malvira/econotag/README.md

CAD and Docs for the Econotag
================================

License
-------

The TH12 designs are owned by Redwire Consulting, LLC and relased
under the [CERN OPEN HARDWARE LICENCE v1.1](LICENSE.txt)
