malvira/econotag/r2/econotag-r2-bom.ods

 | qty | run price | unit price | Sale price | Profit
Pilot | 1 | 48 | 48 | 55 | 31.79
Limited | 100 | 3060 | 31 | 55 | 2439.75
Production | 1000 | 21424 | 21 | 45 | 23575.6
Quantity | Manufacturer | Part Number | Value | Description | Digikey | Mouser | 1 | 100 | 1000 | Pilot Total | LP total | Prod Tot | Pilot $ | Pilot % | LP $ | LP % | P $ | P %
3 | Murata | GRM188F51E105ZA12D | 1uF | Multilayer Ceramic Capacitors (MLCC) - SMD/SMT 0603 1uF 25volts Y5V +80-20% |  | 81-GRM188F51E105ZA12 | 0.0700 | 0.0420 | 0.0160 | 3 | 300 | 3000 | $0.21 | 0.4% | $12.60 | 0.4% | $48.00 | 0.2%
2 | Murata | GRM21BR60J106KE19L | 10uF | Multilayer Ceramic Capacitors (MLCC) - SMD/SMT 0805 10uF 6.3volts X5R 10% |  | 81-GRM21R60J106KE19L | 0.3200 | 0.1910 | 0.0600 | 2 | 200 | 2000 | $0.64 | 1.3% | $38.20 | 1.2% | $120.00 | 0.6%
2 | Kemet | C0603C120C5GACTU | 12pF | Multilayer Ceramic Capacitors (MLCC) - SMD/SMT 50volts 12pF C0G 0.25% |  | 80-C0603C120C5G | 0.7600 | 0.4520 | 0.1250 | 2 | 200 | 2000 | $1.52 | 3.2% | $90.40 | 3.0% | $250.00 | 1.2%
3 | Taiyo Yuden | TMK107BJ104KA-T | 0.1uF | CAP CER .10UF 25V X5R 0603 | 587-1245-1-ND |  | 0.0330 | 0.0195 | 0.0078 | 3 | 300 | 3000 | $0.10 | 0.2% | $5.85 | 0.2% | $23.40 | 0.1%
1 | Vishay/Vitramon | VJ0603A471JXAAC | 470pF | Multilayer Ceramic Capacitors (MLCC) - SMD/SMT 470pF 50volts 5% |  | 77-VJ0603A471JXAAC | 0.0400 | 0.0200 | 0.0200 | 1 | 100 | 1000 | $0.04 | 0.1% | $2.00 | 0.1% | $20.00 | 0.1%
2 | Murata | GRM1885C1H180GA01D | 18pF | Multilayer Ceramic Capacitors (MLCC) - SMD/SMT 0603 18pF 50volts C0G 2% |  | 81-GRM1885C1H180GA | 0.0700 | 0.0440 | 0.0170 | 2 | 200 | 2000 | $0.14 | 0.3% | $8.80 | 0.3% | $34.00 | 0.2%
1 | NXP Semiconductors | PMEG3010ER,115 |  | Schottky (Diodes & Rectifiers) SCHOTTKY DIODE |  | 771-PMEG3010ER115 | 0.1200 | 0.1100 | 0.0960 | 1 | 100 | 1000 | $0.12 | 0.2% | $11.00 | 0.4% | $96.00 | 0.4%
1 | Molex | 48037-1000 | MOLEX-48037-NOHOLES | USB & Firewire Connectors TYPE A RA SHLDED PLG SMT AU |  | 538-48037-1000 | 2.0500 | 1.2000 | 0.8600 | 1 | 100 | 1000 | $2.05 | 4.3% | $120.00 | 3.9% | $860.00 | 4.0%
1 | Vishay/Dale | CRCW06030000ZSTB | short | Jumper Resistors / Wire Bridges 1/10watt 0ohms JUMPER |  | 71-CRCW0603000ZT-RT5 | 0.0500 | 0.0200 | 0.0100 | 1 | 100 | 1000 | $0.05 | 0.1% | $2.00 | 0.1% | $10.00 | 0.0%
1 | ABRACON | ABLS2-12.000MHZ-D4Y-T | 12MHz | 12MHz xtal 18pF |  | 815-ABLS2-12-D4Y-T | 0.6300 | 0.3800 | 0.2380 | 1 | 100 | 1000 | $0.63 | 1.3% | $38.00 | 1.2% | $238.00 | 1.1%
1 | Abracon Corporation | ABLS-24.000MHZ-D-R60-1-W-T | 24MHz 10ppm | 24MHz xtal 10ppm | 535-9701-1-ND |  | 0.9400 | 0.5625 | 0.4750 | 1 | 100 | 1000 | $0.94 | 1.9% | $56.25 | 1.8% | $475.00 | 2.2%
1 | Kingbright | APT1608SRCPRV | RED | Standard LED - SMD RED WATER CLEAR |  | 604-APT1608SRCPRV | 0.1300 | 0.0710 | 0.0490 | 1 | 100 | 1000 | $0.13 | 0.3% | $7.10 | 0.2% | $49.00 | 0.2%
1 | Lite-On Inc | LTST-C190KGKT | GREEN | LED GREEN CLEAR 0603 SMD | 160-1435-1-ND |  | 0.1200 | 0.0725 | 0.0580 | 1 | 100 | 1000 | $0.12 | 0.2% | $7.25 | 0.2% | $58.00 | 0.3%
1 | Xicon | 302-8.06K-RC | 8.06k | Thick Film Resistors 1/10WATT 8.06KOHMS |  | 302-8.06K-RC | 0.0400 | 0.0250 | 0.0140 | 1 | 100 | 1000 | $0.04 | 0.1% | $2.50 | 0.1% | $14.00 | 0.1%
2 | Bourns | CR0603-JW-102GLF | 1k | Thick Film Resistors 1KOHM 1/10WATT 5% |  | 652-CR0603-JW-102GLF | 0.0300 | 0.0200 | 0.0150 | 2 | 200 | 2000 | $0.06 | 0.1% | $4.00 | 0.1% | $30.00 | 0.1%
1 | Bourns | CR0603-JW-221GLF | 220 | Thick Film Resistors 220OHM 1/10WATT 5% |  | 652-CR0603-JW-221GLF | 0.0300 | 0.0200 | 0.0150 | 1 | 100 | 1000 | $0.03 | 0.1% | $2.00 | 0.1% | $15.00 | 0.1%
1 | Xicon | 301-120-RC | 120 | Thick Film Resistors 1/16WATT 120OHMS |  | 301-120-RC | 0.0400 | 0.0240 | 0.0160 | 1 | 100 | 1000 | $0.04 | 0.1% | $2.40 | 0.1% | $16.00 | 0.1%
1 | Vishay/Dale | CRCW06031K02FKTA | 1.02k | Thick Film Resistors 1/10watt 1.02Kohms 1% |  | 71-CRCW0603-1.02K | 0.0500 | 0.0200 | 0.0100 | 1 | 100 | 1000 | $0.05 | 0.1% | $2.00 | 0.1% | $10.00 | 0.0%
1 | Xicon | 302-15K-RC | 15.0k | Thick Film Resistors 1/10WATT 15KOHMS |  | 302-15K-RC | 0.0400 | 0.0250 | 0.0140 | 1 | 100 | 1000 | $0.04 | 0.1% | $2.50 | 0.1% | $14.00 | 0.1%
2 | KOA Speer | RK73B1JTTD563J | 56k | Thick Film Resistors 1/10watts 56Kohms 5% |  | 660-RK73B1JTTD563J | 0.0600 | 0.0200 | 0.0160 | 2 | 200 | 2000 | $0.12 | 0.2% | $4.00 | 0.1% | $32.00 | 0.1%
1 | KOA Speer | RK73H1JTTD1202F | 12k | Thick Film Resistors 1/10watts 12Kohms 1% |  | 660-RK73H1JTTD1202F | 0.0800 | 0.0200 | 0.0150 | 1 | 100 | 1000 | $0.08 | 0.2% | $2.00 | 0.1% | $15.00 | 0.1%
1 | Xicon | 301-10M-RC | 10M | Thick Film Resistors 1/16WATT 10MOHMS |  | 301-10M-RC | 0.0400 | 0.0240 | 0.0160 | 1 | 100 | 1000 | $0.04 | 0.1% | $2.40 | 0.1% | $16.00 | 0.1%
1 | Bourns | CR0603-JW-333GLF | 33k | Thick Film Resistors 33KOHM 1/10WATT 5% |  | 652-CR0603-JW-333GLF | 0.0300 | 0.0200 | 0.0150 | 1 | 100 | 1000 | $0.03 | 0.1% | $2.00 | 0.1% | $15.00 | 0.1%
3 | C&K Components | KSC243JLFG |  | Tactile & Jog Switches Gold 300Gf J-Lead |  | 611-KSC243JLFG | 0.5400 | 0.4000 | 0.2560 | 3 | 300 | 3000 | $1.62 | 3.4% | $120.00 | 3.9% | $768.00 | 3.6%
1 | Freescale Semiconductor | MC13224V | MC13224V-LGA145 | RF Transceiver PIP 802.15.4 2.4G IND Learn More |  | 841-MC13224V | 5.8500 | 5.1100 | 5.1100 | 1 | 100 | 1000 | $5.85 | 12.1% | $511.00 | 16.7% | $5,110.00 | 23.9%
1 | FTDI, Future Technology Devices International Ltd | FT2232HL - REEL | FT2232HL | IC USB UART/FIFO DUAL HS 64LQFP | 768-1024-1-ND |  | 6.7100 | 5.4000 | 4.0600 | 1 | 100 | 1000 | $6.71 | 13.9% | $540.00 | 17.6% | $4,060.00 | 19.0%
1 | Micrel Inc | MIC5205YM5 TR | MIC5205-BM5 | Adj. Vreg | 576-1262-1-ND |  | 0.8100 | 0.5400 | 0.3780 | 1 | 100 | 1000 | $0.81 | 1.7% | $54.00 | 1.8% | $378.00 | 1.8%
1 | 4PCB |  |  | PCB |  |  | 6.0000 | 5.3400 | 2.5100 | 1 | 100 | 1000 | $6.00 | 12.4% | $534.00 | 17.4% | $2,510.00 | 11.7%
1 | Proxy |  |  | Assembly |  |  | 20.0000 | 8.7600 | 6.1400 | 1 | 100 | 1000 | $20.00 | 41.5% | $876.00 | 28.6% | $6,140.00 | 28.7%
