malvira/econotag/r2/econotag-r2-print.pdf

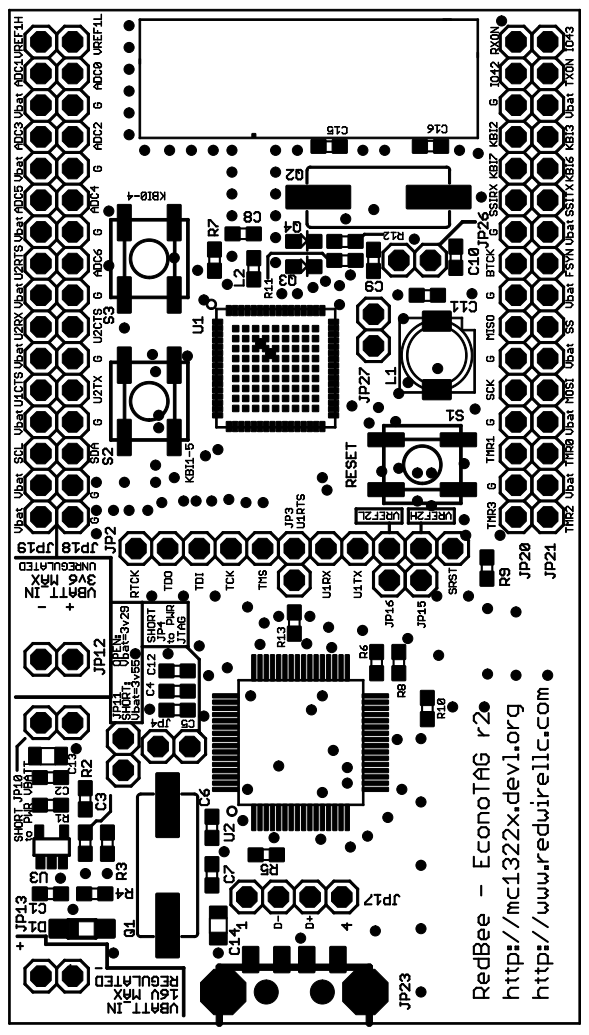
[picture p1: page 1]
